silver-sat/Avionics_Board/Avionics_Board.step

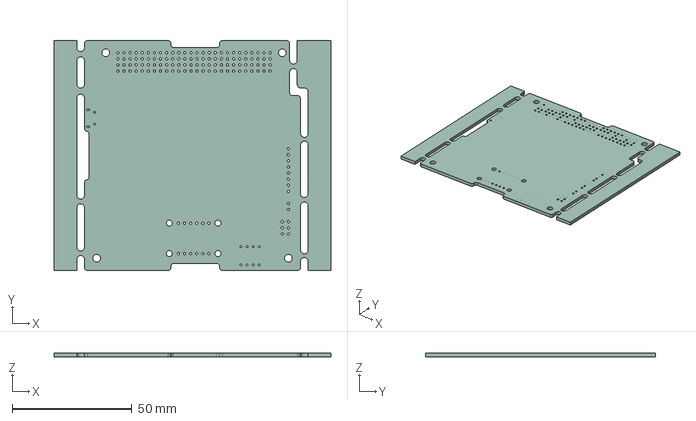
[picture p1: CAD file, 2024-04-20]
Avionics_Board.step
115.6 x 95.9 x 1.77 mm
