silver-sat/Avionics_Board/avionics_board_layout_04182022.dxf

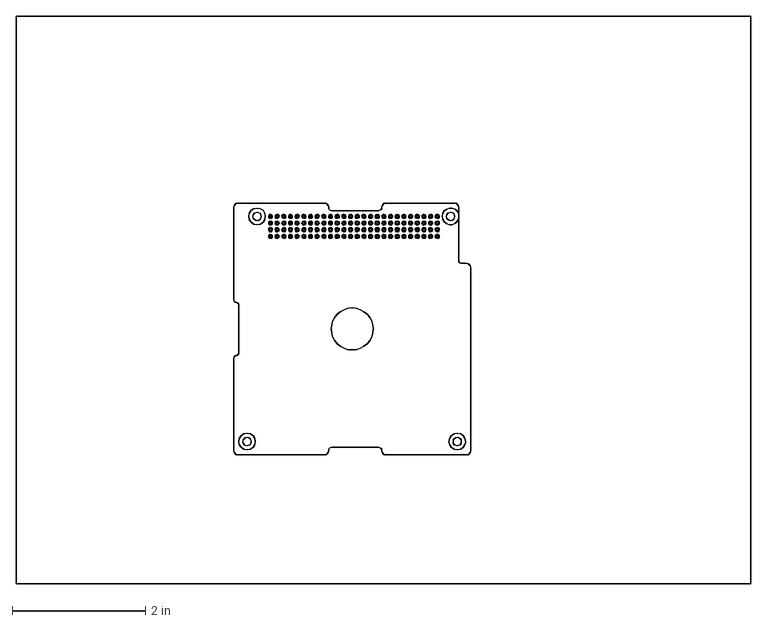
[picture p2: CAD file, 2023-02-25]
avionics_board_layout_04182022.dxf
11.0 x 8.50 in
