silver-sat/Avionics_Board/(threads)

Thread 4 (2023-06-26):

Payload Board Receives Power until Avionics Board Initializes

lcongdon, 2023-06-26:
See https://github.com/silver-sat/Avionics_Software/issues/332

lcongdon, 2023-06-28:
Also tracked as https://github.com/silver-sat/Payload_Board/issues/4

NiskiN, 2023-11-11:
The Pullup Resistors have been added.

Closed 2023-11-11.

Thread 5 (2023-06-28):

Jumpers for Power and Radio I2C Connections are Open

lcongdon, 2023-06-28:
Need to close clock and data jumpers for the Power and Radio I2C connections

NiskiN, 2023-11-11:
The Jumpers have been Closed

Closed 2023-11-11.
