silver-sat/Avionics_Board/Avionics_Board.kicad_pcb

## KiCad design Avionics_Board.kicad_pcb (2024-06-05)

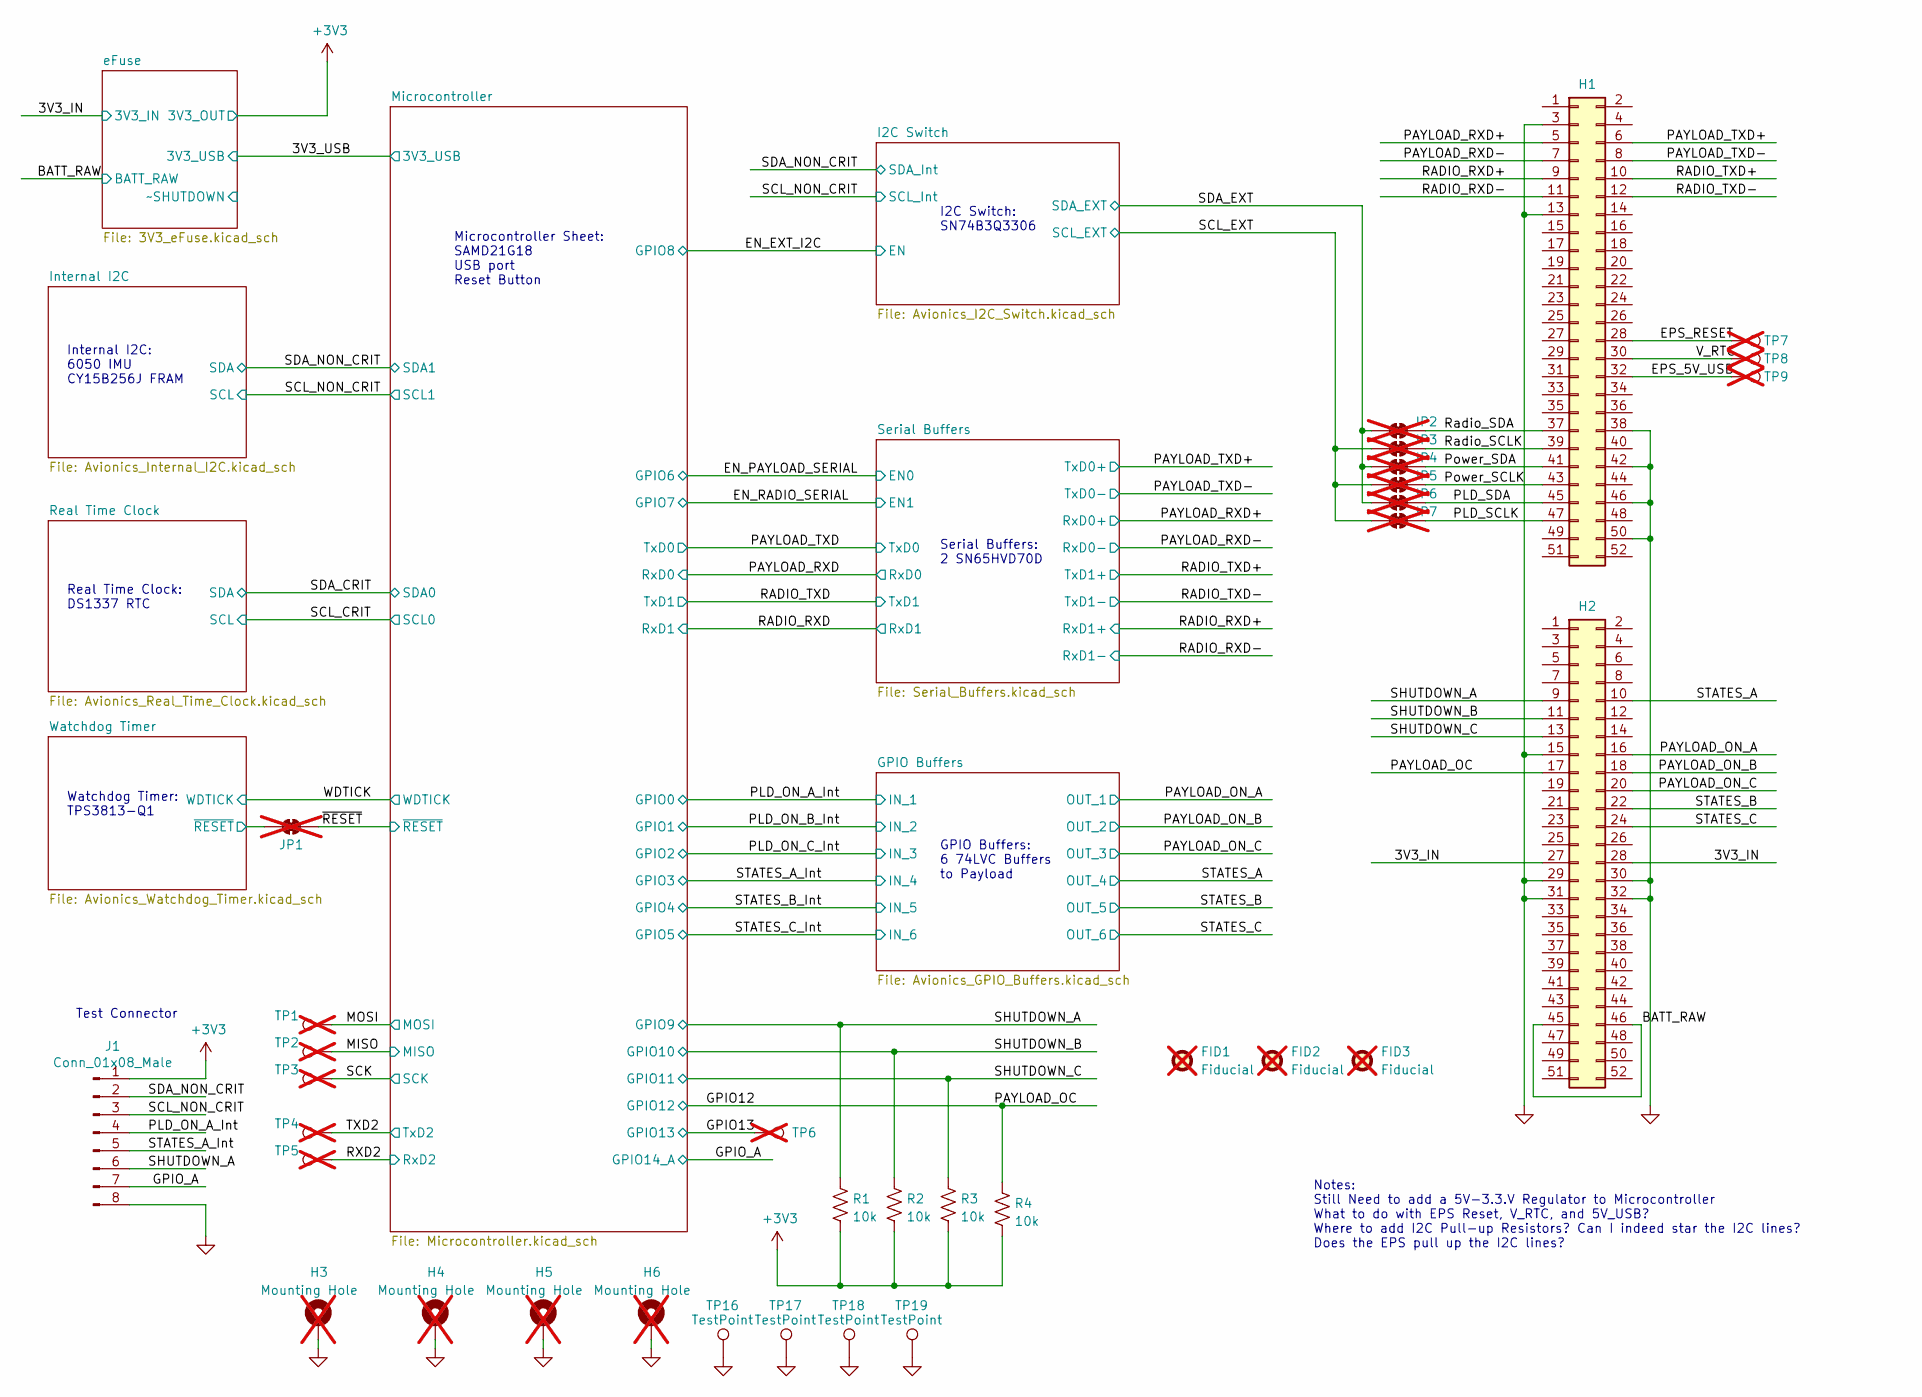
[picture p3: schematic Avionics_Board.kicad_sch, Avionics Board]

Parts:
FID1, FID2, FID3: Fiducial; Fiducial_1.5mm_Mask2.5mm; not fitted
H1, H2: Conn_02x26_Odd_Even; TheBus2x26; Part_Number ESQ-126-37-G-D
H3, H4, H5, H6: Mounting Hole; MountingHole_3.2mm_M3_Pad; not fitted
J1: Conn_01x08_Male; PinHeader_1x08_P2.54mm_Vertical; MPN TSW-108-26-L-S
JP1, JP2, JP3, JP4, JP5, JP6, JP7: SolderJumper_2_Bridged; SolderJumper-2_P1.3mm_Open_RoundedPad1.0x1.5mm; not fitted
R1, R2, R3, R4: 10k; R_0603_1608Metric; Part_Number ERJ-3EKF1002V
TP1: MOSI; TestPoint_Pad_2.0x2.0mm; not fitted
TP2: MISO; TestPoint_Pad_2.0x2.0mm; not fitted
TP3: SCK; TestPoint_Pad_2.0x2.0mm; not fitted
TP4: TXD2; TestPoint_Pad_2.0x2.0mm; not fitted
TP5: RXD2; TestPoint_Pad_2.0x2.0mm; not fitted
TP6: GPIO13; TestPoint_Pad_2.0x2.0mm; not fitted
TP7: EPS_RESET; TestPoint_Pad_2.0x2.0mm; not fitted
TP8: V_RTC; TestPoint_Pad_2.0x2.0mm; not fitted
TP9: EPS_5V_USB; TestPoint_Pad_2.0x2.0mm; not fitted
TP16, TP17, TP18, TP19: TestPoint; TestPoint_Keystone_5019_Minature; MPN 5019

Connections:
+3V3: J1.1, R1.2, R2.2, R3.2, R4.2; also elsewhere on the board
/3V3_IN: H2.27, H2.28; also elsewhere on the board
/BATT_RAW: H2.45, H2.46; also elsewhere on the board
/EPS_5V_USB: H1.32, TP9.1
/EPS_RESET: H1.28, TP7.1
/GPIO12: H2.17, R4.1; also elsewhere on the board
/GPIO13: TP6.1; also elsewhere on the board
/GPIO_A: J1.7; also elsewhere on the board
/MISO: TP2.1; also elsewhere on the board
/MOSI: TP1.1; also elsewhere on the board
/PAYLOAD_ON_A: H2.16; also elsewhere on the board
/PAYLOAD_ON_B: H2.18; also elsewhere on the board
/PAYLOAD_ON_C: H2.20; also elsewhere on the board
/PAYLOAD_RXD+: H1.5; also elsewhere on the board
/PAYLOAD_RXD-: H1.7; also elsewhere on the board
/PAYLOAD_TXD+: H1.6; also elsewhere on the board
/PAYLOAD_TXD-: H1.8; also elsewhere on the board
/PLD_ON_A_Int: J1.4; also elsewhere on the board
/PLD_SCLK: H1.47, JP7.2 (B)
/PLD_SDA: H1.45, JP6.2 (B)
/Power_SCLK: H1.43, JP5.2 (B)
/Power_SDA: H1.41, JP4.2 (B)
/RADIO_RXD+: H1.9; also elsewhere on the board
/RADIO_RXD-: H1.11; also elsewhere on the board
/RADIO_TXD+: H1.10; also elsewhere on the board
/RADIO_TXD-: H1.12; also elsewhere on the board
/RXD2: TP5.1; also elsewhere on the board
/Radio_SCLK: H1.39, JP3.2 (B)
/Radio_SDA: H1.37, JP2.2 (B)
/SCK: TP3.1; also elsewhere on the board
/SCL_EXT: JP3.1 (A), JP5.1 (A), JP7.1 (A); also elsewhere on the board
/SCL_NON_CRIT: J1.3; also elsewhere on the board
/SDA_EXT: JP2.1 (A), JP4.1 (A), JP6.1 (A); also elsewhere on the board
/SDA_NON_CRIT: J1.2; also elsewhere on the board
/SHUTDOWN_A: H2.9, J1.6, R1.1; also elsewhere on the board
/SHUTDOWN_B: H2.11, R2.1; also elsewhere on the board
/SHUTDOWN_C: H2.13, R3.1; also elsewhere on the board
/STATES_A: H2.10; also elsewhere on the board
/STATES_A_Int: J1.5; also elsewhere on the board
/STATES_B: H2.22; also elsewhere on the board
/STATES_C: H2.24; also elsewhere on the board
/TXD2: TP4.1; also elsewhere on the board
/V_RTC: H1.30, TP8.1
/Watchdog Timer/~RESET: JP1.1 (A); also elsewhere on the board
/~RESET: JP1.2 (B); also elsewhere on the board
GND: H1.3, H1.13, H1.38, H1.42, H1.46, H1.50, H2.15, H2.29, H2.30, H2.31, H2.32, H3.1, H4.1, H5.1, H6.1, J1.8, TP16.1, TP17.1, TP18.1, TP19.1; also elsewhere on the board

Notes on the sheet:
GPIO Buffers: 6 74LVC Buffers to Payload
Serial Buffers: 2 SN65HVD70D
Watchdog Timer: TPS3813-Q1
Real Time Clock: DS1337 RTC
Microcontroller Sheet: SAMD21G18 USB port Reset Button
Notes: Still Need to add a 5V-3.3.V Regulator to Microcontroller What to do with EPS Reset, V_RTC, and 5V_USB? Where to add I2C Pull-up Resistors? Can I indeed star the I2C lines? Does the EPS pull up the I2C lines?
Internal I2C: 6050 IMU CY15B256J FRAM
I2C Switch: SN74B3Q3306
Test Connector

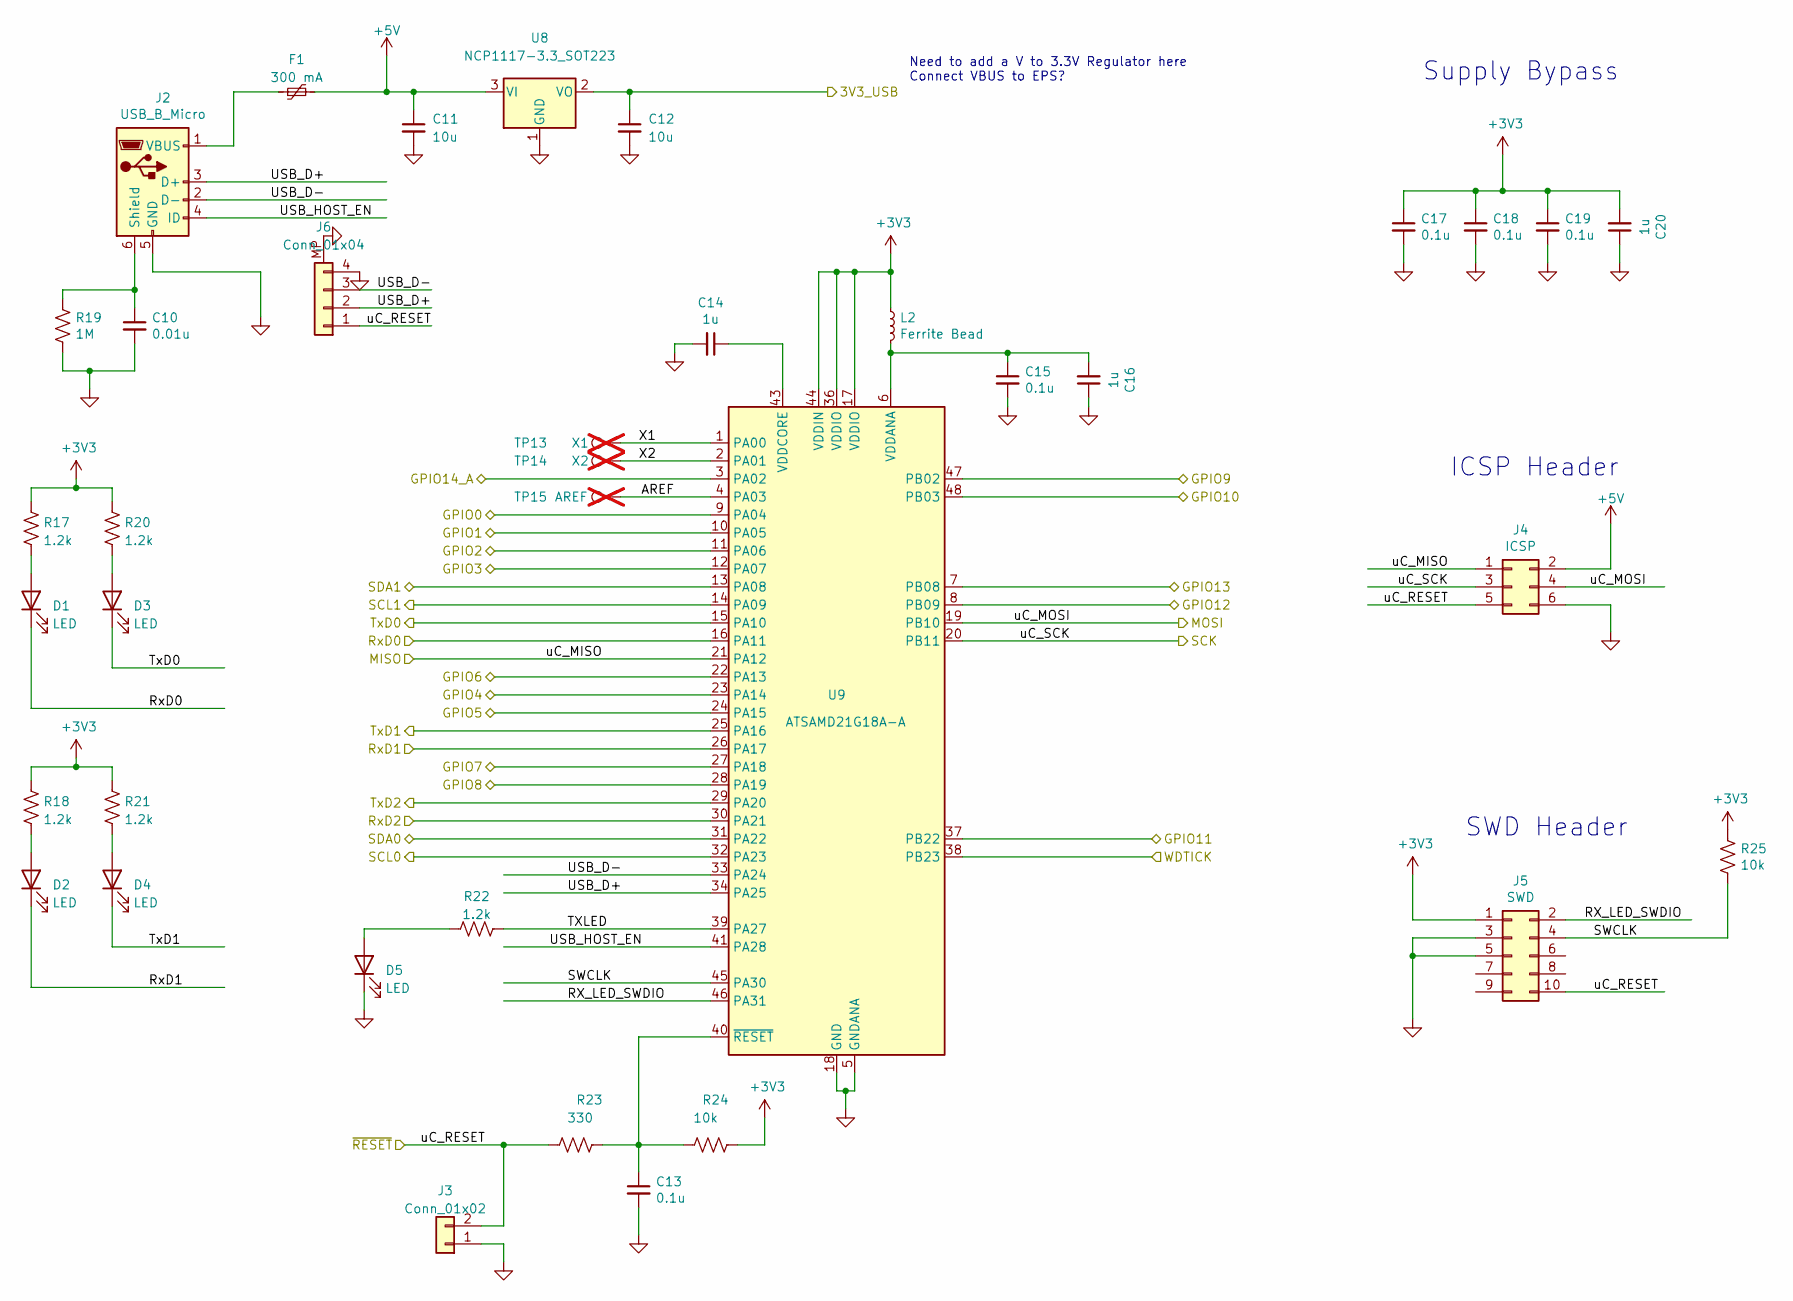
[picture p4: schematic Microcontroller.kicad_sch, Avionics Board]

Parts:
C10: 0.01u; C_0603_1608Metric; Part_Number 06035C472K4Z2A
C11, C12: 10u; C_2220_5650Metric_Pad1.97x5.40mm_HandSolder; Part_Number 22205C106K4Z4A
C13, C15, C17, C18, C19: 0.1u; C_0603_1608Metric; Part_Number 06035C104K4Z2A
C14, C16, C20: 1u; C_1206_3216Metric; Part_Number 12065C105M4Z2A
D1, D2, D3, D4, D5: LED; LED_0603_1608Metric; MPN CSL0903UT1C
F1: 300 mA; Fuse_0805_2012Metric; Part_Number PICOASMDC012S-2
J2: USB_B_Micro; USB_Micro-B_Molex-105017-0001; Part_Number 105017-0001
J3: Conn_01x02; PinHeader_1x02_P2.54mm_Vertical; MPN TSW-102-26-L-S
J4: ICSP; PinHeader_2x03_P2.54mm_Vertical; MPN MTSW-103-06-G-D-110
J5: SWD; PinHeader_2x05_P1.27mm_Vertical_SMD; Part_Number 4048
J6: Conn_01x04; Molex_PicoBlade_53261-0471_1x04-1MP_P1.25mm_Horizontal; MPN 53261-0471
L2: Ferrite Bead; L_0603_1608Metric; Part_Number BLM18SP102SH1D
R17, R18, R20, R21, R22: 1.2k; R_0603_1608Metric; Part_Number ERJ-3EKF9310V
R19: 1M; R_0603_1608Metric; Part_Number ERJ-3EKF1004V
R23: 330; R_0603_1608Metric; Part_Number ERJ-3EKF3300V
R24, R25: 10k; R_0603_1608Metric; Part_Number ERJ-3EKF1002V
TP13: X1; TestPoint_Pad_2.0x2.0mm; not fitted
TP14: X2; TestPoint_Pad_2.0x2.0mm; not fitted
TP15: AREF; TestPoint_Pad_2.0x2.0mm; not fitted
U8: NCP1117-3.3_SOT223; SOT-223-3_TabPin2; Part_Number NCP1117
U9: ATSAMD21G18A-A; TQFP-48_7x7mm_P0.5mm; Part_Number ATSAMD21G18A-AF

Connections:
+3V3: C17.1, C18.1, C19.1, C20.2, J5.1, L2.1, R17.1, R18.1, R20.1, R21.1, R24.1, R25.1, U9.17 (VDDIO), U9.36 (VDDIO), U9.44 (VDDIN); also elsewhere on the board
+5V: C11.1, F1.2, J4.2, U8.3 (VI)
/3V3_USB: C12.1, U8.2 (VO); also elsewhere on the board
/EN_EXT_I2C: U9.28 (PA19); also elsewhere on the board
/EN_PAYLOAD_SERIAL: U9.22 (PA13); also elsewhere on the board
/EN_RADIO_SERIAL: U9.27 (PA18); also elsewhere on the board
/GPIO12: U9.8 (PB09); also elsewhere on the board
/GPIO13: U9.7 (PB08); also elsewhere on the board
/GPIO_A: U9.3 (PA02); also elsewhere on the board
/MISO: J4.1, U9.21 (PA12); also elsewhere on the board
/MOSI: J4.4, U9.19 (PB10); also elsewhere on the board
/Microcontroller/AREF: TP15.1, U9.4 (PA03)
/Microcontroller/RX_LED_SWDIO: J5.2, U9.46 (PA31)
/Microcontroller/SWCLK: J5.4, R25.2, U9.45 (PA30)
/Microcontroller/TXLED: R22.2, U9.39 (PA27)
/Microcontroller/USB_D+: J2.3 (D+), J6.2, U9.34 (PA25)
/Microcontroller/USB_D-: J2.2 (D-), J6.3, U9.33 (PA24)
/Microcontroller/USB_HOST_EN: J2.4 (ID), U9.41 (PA28)
/Microcontroller/X1: TP13.1, U9.1 (PA00)
/Microcontroller/X2: TP14.1, U9.2 (PA01)
/PAYLOAD_RXD: D1.1 (K), U9.16 (PA11); also elsewhere on the board
/PAYLOAD_TXD: D3.1 (K), U9.15 (PA10); also elsewhere on the board
/PLD_ON_A_Int: U9.9 (PA04); also elsewhere on the board
/PLD_ON_B_Int: U9.10 (PA05); also elsewhere on the board
/PLD_ON_C_Int: U9.11 (PA06); also elsewhere on the board
/RADIO_RXD: D2.1 (K), U9.26 (PA17); also elsewhere on the board
/RADIO_TXD: D4.1 (K), U9.25 (PA16); also elsewhere on the board
/RXD2: U9.30 (PA21); also elsewhere on the board
/SCK: J4.3, U9.20 (PB11); also elsewhere on the board
/SCL_CRIT: U9.32 (PA23); also elsewhere on the board
/SCL_NON_CRIT: U9.14 (PA09); also elsewhere on the board
/SDA_CRIT: U9.31 (PA22); also elsewhere on the board
/SDA_NON_CRIT: U9.13 (PA08); also elsewhere on the board
/SHUTDOWN_A: U9.47 (PB02); also elsewhere on the board
/SHUTDOWN_B: U9.48 (PB03); also elsewhere on the board
/SHUTDOWN_C: U9.37 (PB22); also elsewhere on the board
/STATES_A_Int: U9.12 (PA07); also elsewhere on the board
/STATES_B_Int: U9.23 (PA14); also elsewhere on the board
/STATES_C_Int: U9.24 (PA15); also elsewhere on the board
/TXD2: U9.29 (PA20); also elsewhere on the board
/WDTICK: U9.38 (PB23); also elsewhere on the board
/~RESET: J3.2, J4.5, J5.10, J6.1, R23.2; also elsewhere on the board
GND: C10.2, C11.2, C12.2, C13.2, C14.2, C15.2, C16.1, C17.2, C18.2, C19.2, C20.1, D5.1 (K), J2.5 (GND), J3.1, J4.6, J5.3, J5.5, J6.4, J6.MP, R19.2, U8.1 (GND), U9.5 (GNDANA), U9.18 (GND), U9.35 (GND), U9.42 (GND); also elsewhere on the board
unnamed: D1.2 (A), R17.2
unnamed: D2.2 (A), R18.2
unnamed: D3.2 (A), R20.2
unnamed: D4.2 (A), R21.2
unnamed: D5.2 (A), R22.1
unnamed: C10.1, J2.6 (Shield), R19.1
unnamed: F1.1, J2.1 (VBUS)
unnamed: C15.1, C16.2, L2.2, U9.6 (VDDANA)
unnamed: C14.1, U9.43 (VDDCORE)
unnamed: C13.1, R23.1, R24.2, U9.40 (~RESET)

Notes on the sheet:
Need to add a V to 3.3V Regulator here Connect VBUS to EPS?
ICSP Header
SWD Header
Supply Bypass

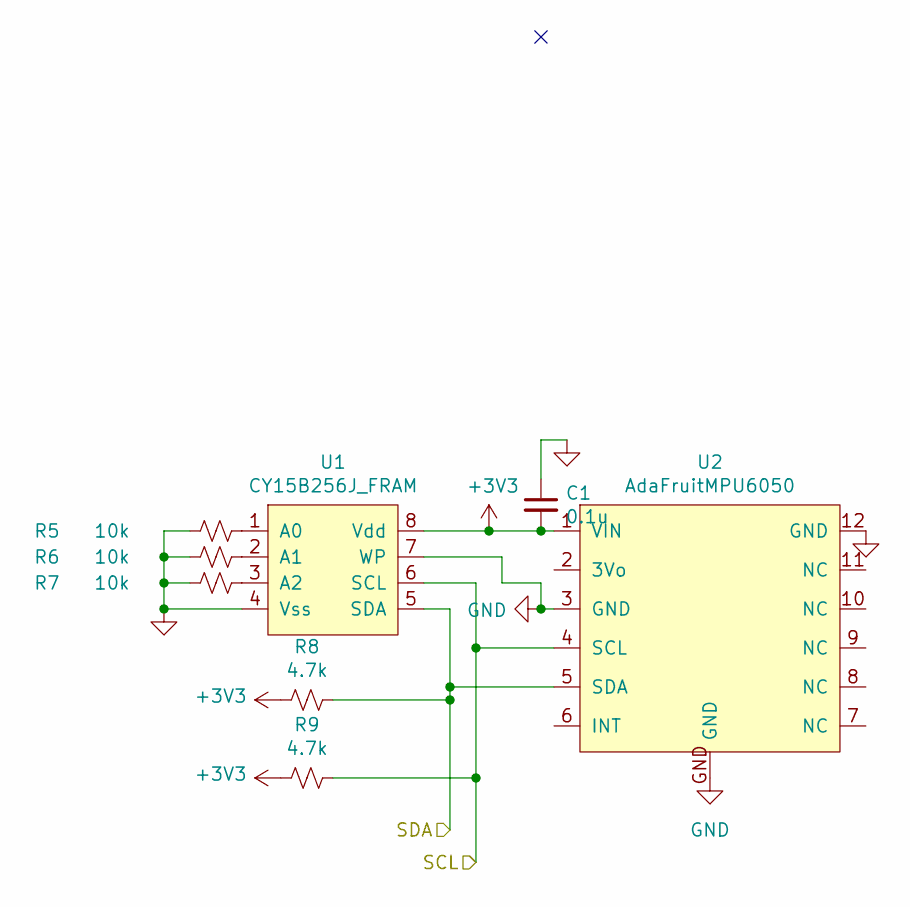
[picture p5: schematic Avionics_Internal_I2C.kicad_sch, Avionics Board]

Parts:
C1: 0.1u; C_0603_1608Metric; Part_Number 06035C104K4Z2A
R5, R6, R7: 10k; R_0603_1608Metric; Part_Number ERJ-3EKF1002V
R8, R9: 4.7k; R_0603_1608Metric; Part_Number ERJ-3EKF4701V
U1: CY15B256J_FRAM; SOP-8_5.28x5.23mm_P1.27mm; Part_Number CY15B256J
U2: AdaFruitMPU6050; MPU_6050; Part_Number MPU6050

Connections:
+3V3: C1.2, R8.2, R9.2, U1.8 (Vdd), U2.1 (VIN); also elsewhere on the board
/SCL_NON_CRIT: R9.1, U1.6 (SCL), U2.4 (SCL); also elsewhere on the board
/SDA_NON_CRIT: R8.1, U1.5 (SDA), U2.5 (SDA); also elsewhere on the board
GND: C1.1, R5.2, R6.2, R7.2, U1.4 (Vss), U1.7 (WP), U2.3 (GND), U2.12 (GND), U2.GND; also elsewhere on the board
unnamed: R5.1, U1.1 (A0)
unnamed: R6.1, U1.2 (A1)
unnamed: R7.1, U1.3 (A2)

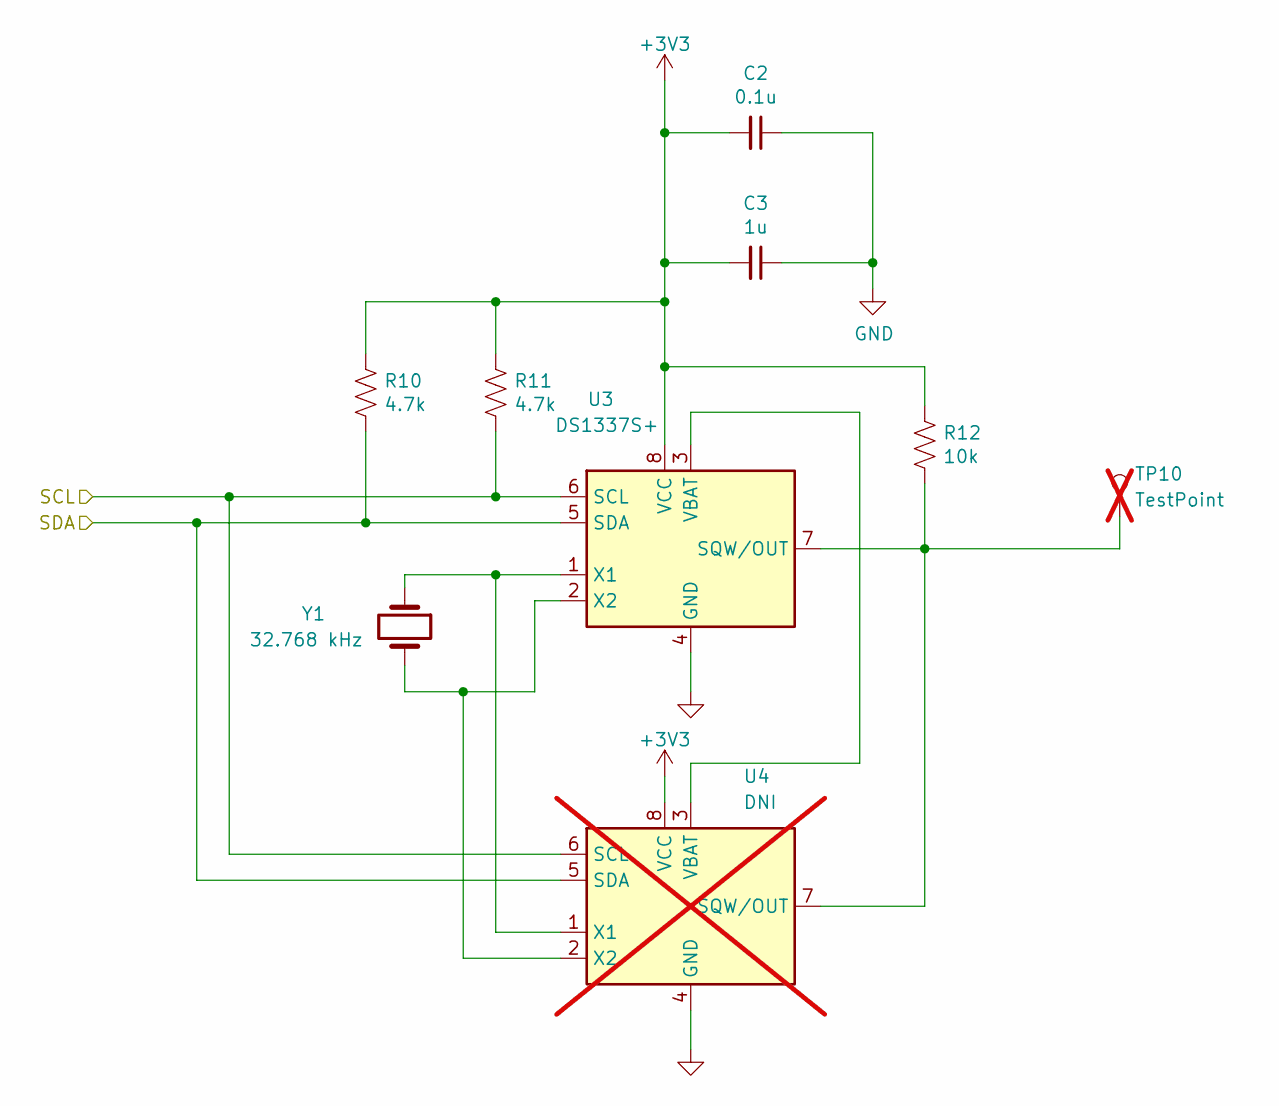
[picture p6: schematic Avionics_Real_Time_Clock.kicad_sch, Avionics Board]

Parts:
C2: 0.1u; C_0603_1608Metric; Part_Number 06035C104K4Z2A
C3: 1u; C_1206_3216Metric; Part_Number 12065C105M4Z2A
R10, R11: 4.7k; R_0603_1608Metric; Part_Number ERJ-3EKF4701V
R12: 10k; R_0603_1608Metric; Part_Number ERJ-3EKF1002V
TP10: TestPoint; TestPoint_Pad_2.0x2.0mm; not fitted
U3: DS1337S+; SOIC-8_3.9x4.9mm_P1.27mm; Part_Number DS1337S+T&R
U4: DNI; DIP-8_W7.62mm; Part_Number DS1337+; not fitted
Y1: 32.768 kHz; Crystal_SMD_3215-2Pin_3.2x1.5mm; Part_Number ECS-.327-6-34QCS-TR

Connections:
+3V3: C2.2, C3.2, R10.1, R11.1, R12.1, U3.8 (VCC), U4.8 (VCC); also elsewhere on the board
/SCL_CRIT: R11.2, U3.6 (SCL), U4.6 (SCL); also elsewhere on the board
/SDA_CRIT: R10.2, U3.5 (SDA), U4.5 (SDA); also elsewhere on the board
GND: C2.1, C3.1, U3.4 (GND), U4.4 (GND); also elsewhere on the board
unnamed: R12.2, TP10.1, U3.7 (SQW/OUT), U4.7 (SQW/OUT)
unnamed: U3.3 (VBAT), U4.3 (VBAT)
unnamed: U3.1 (X1), U4.1 (X1), Y1.1
unnamed: U3.2 (X2), U4.2 (X2), Y1.2

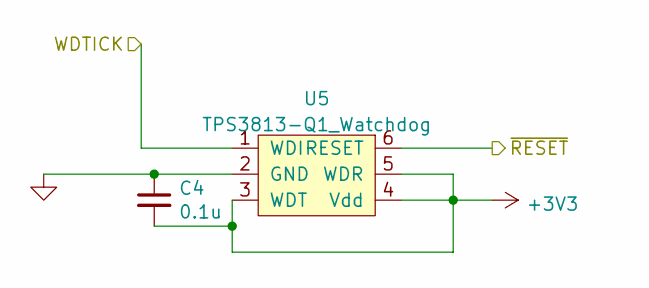
[picture p7: schematic Avionics_Watchdog_Timer.kicad_sch, Avionics Board]

Parts:
C4: 0.1u; C_0603_1608Metric; Part_Number 06035C104K4Z2A
U5: TPS3813-Q1_Watchdog; SOT-23-6; Part_Number TPS3813I50QDBVRQ1

Connections:
+3V3: C4.2, U5.3 (WDT), U5.4 (Vdd), U5.5 (WDR); also elsewhere on the board
/WDTICK: U5.1 (WDI); also elsewhere on the board
/Watchdog Timer/~RESET: U5.6 (RESET); also elsewhere on the board
GND: C4.1, U5.2 (GND); also elsewhere on the board

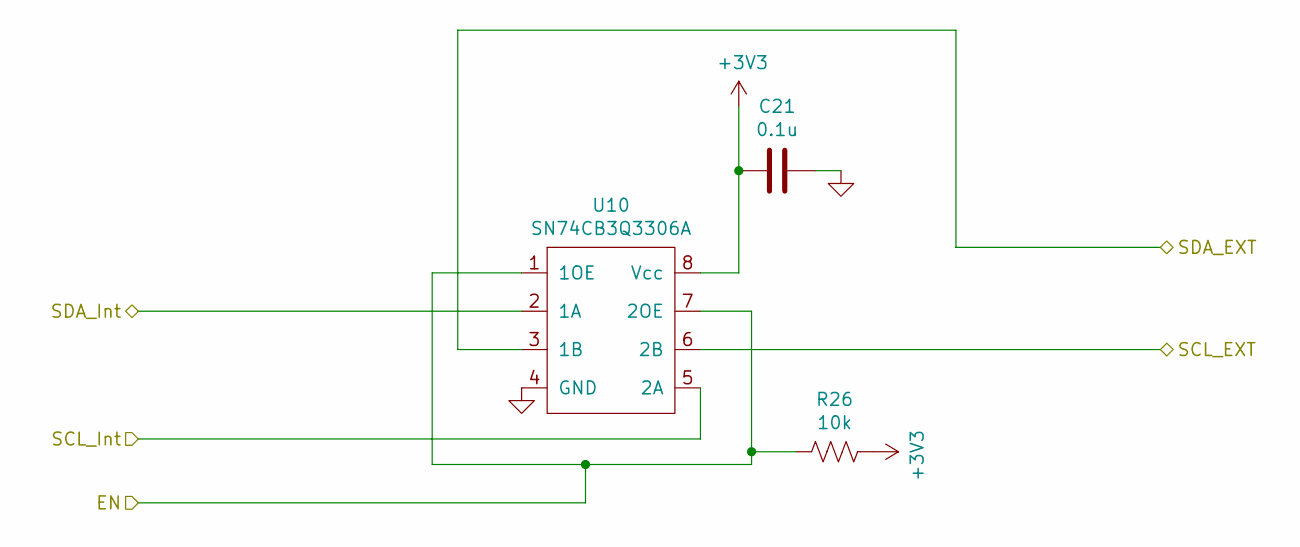
[picture p8: schematic Avionics_I2C_Switch.kicad_sch, Avionics Board]

Parts:
C21: 0.1u; C_0603_1608Metric; Part_Number 06035C104K4Z2A
R26: 10k; R_0603_1608Metric; Part_Number ERJ-3EKF1002V
U10: SN74CB3Q3306A; TSSOP-8_4.4x3mm_P0.65mm; Part_Number SN74CB3Q3306A

Connections:
+3V3: C21.1, R26.1, U10.8 (Vcc); also elsewhere on the board
/EN_EXT_I2C: R26.2, U10.1 (1OE), U10.7 (2OE); also elsewhere on the board
/SCL_EXT: U10.6 (2B); also elsewhere on the board
/SCL_NON_CRIT: U10.5 (2A); also elsewhere on the board
/SDA_EXT: U10.3 (1B); also elsewhere on the board
/SDA_NON_CRIT: U10.2 (1A); also elsewhere on the board
GND: C21.2, U10.4 (GND); also elsewhere on the board

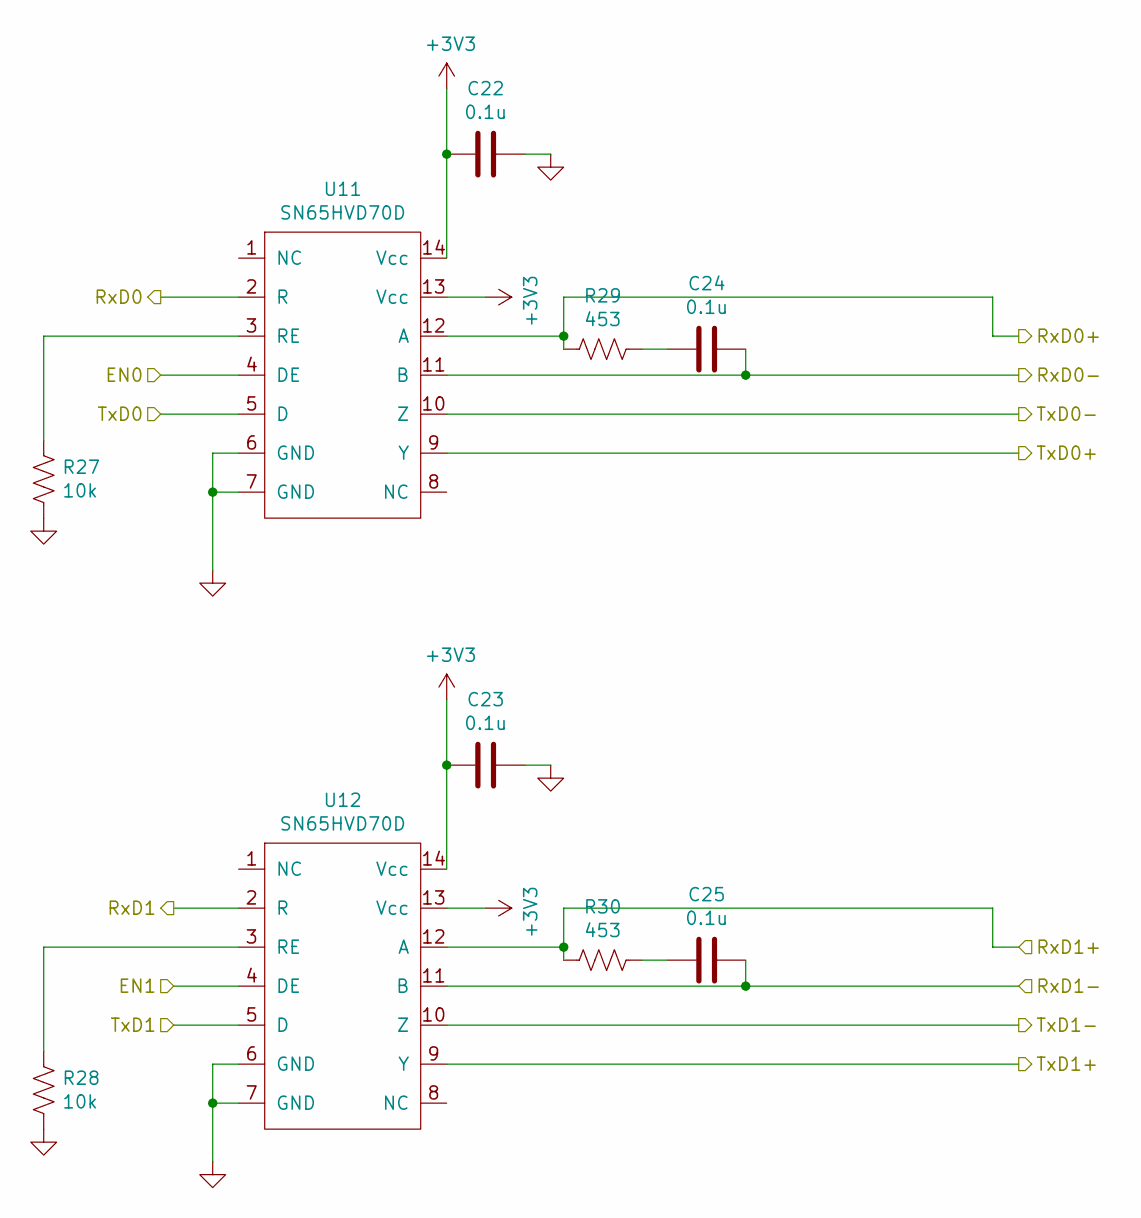
[picture p9: schematic Serial_Buffers.kicad_sch, Avionics Board]

Parts:
C22, C23, C24, C25: 0.1u; C_0603_1608Metric; Part_Number 06035C104K4Z2A
R27, R28: 10k; R_0603_1608Metric; Part_Number ERJ-3EKF1002V
R29, R30: 453; R_0603_1608Metric; Part_Number ERJ-3EKF4530V
U11, U12: SN65HVD70D; SOIC-14_3.9x8.7mm_P1.27mm; Part_Number SN65HVD70D

Connections:
+3V3: C22.1, C23.1, U11.13 (Vcc), U11.14 (Vcc), U12.13 (Vcc), U12.14 (Vcc); also elsewhere on the board
/EN_PAYLOAD_SERIAL: U11.4 (DE); also elsewhere on the board
/EN_RADIO_SERIAL: U12.4 (DE); also elsewhere on the board
/PAYLOAD_RXD: U11.2 (R); also elsewhere on the board
/PAYLOAD_RXD+: R29.2, U11.12 (A); also elsewhere on the board
/PAYLOAD_RXD-: C24.2, U11.11 (B); also elsewhere on the board
/PAYLOAD_TXD: U11.5 (D); also elsewhere on the board
/PAYLOAD_TXD+: U11.9 (Y); also elsewhere on the board
/PAYLOAD_TXD-: U11.10 (Z); also elsewhere on the board
/RADIO_RXD: U12.2 (R); also elsewhere on the board
/RADIO_RXD+: R30.2, U12.12 (A); also elsewhere on the board
/RADIO_RXD-: C25.2, U12.11 (B); also elsewhere on the board
/RADIO_TXD: U12.5 (D); also elsewhere on the board
/RADIO_TXD+: U12.9 (Y); also elsewhere on the board
/RADIO_TXD-: U12.10 (Z); also elsewhere on the board
GND: C22.2, C23.2, R27.2, R28.2, U11.6 (GND), U11.7 (GND), U12.6 (GND), U12.7 (GND); also elsewhere on the board
unnamed: C24.1, R29.1
unnamed: C25.1, R30.1
unnamed: R27.1, U11.3 (RE)
unnamed: R28.1, U12.3 (RE)

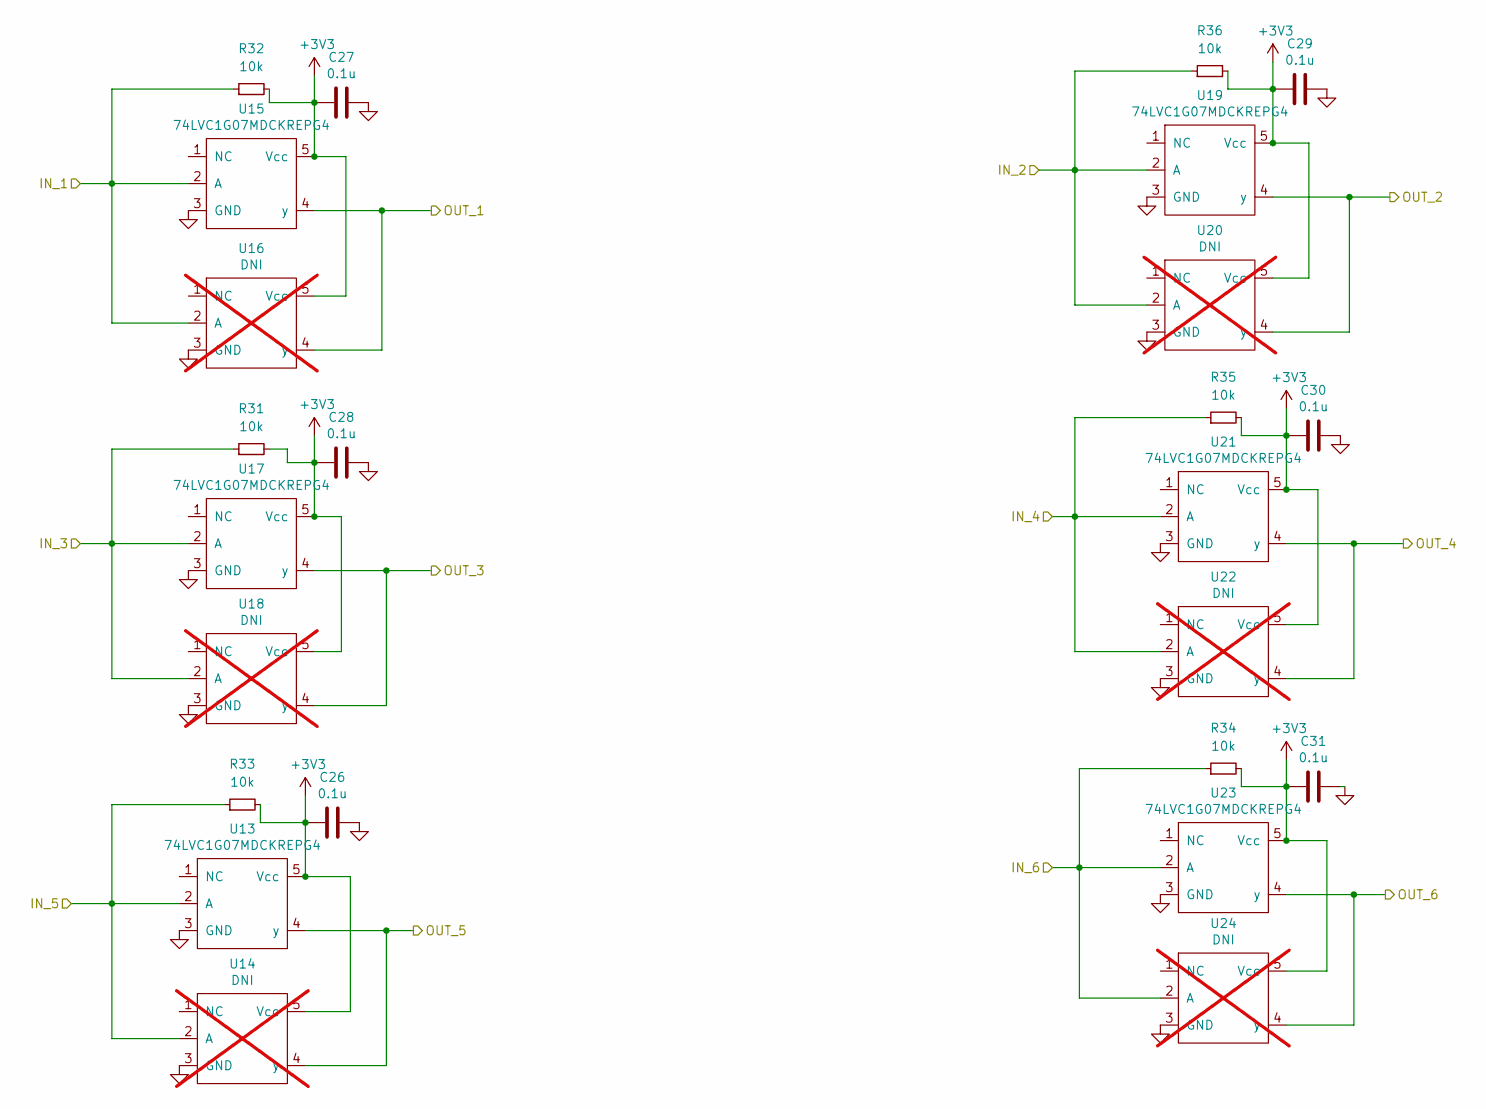
[picture p10: schematic Avionics_GPIO_Buffers.kicad_sch, Avionics Board]

Parts:
C26, C27, C28, C29, C30, C31: 0.1u; C_0603_1608Metric; Part_Number 06035C104K4Z2A
R31, R32, R33, R34, R35, R36: 10k; R_0603_1608Metric; MPN ERJ-3RBD1002V
U13, U15, U17, U19, U21, U23: 74LVC1G07MDCKREPG4; SOT-353_SC-70-5; Part_Number 74LVC1G07MDCKREPG4
U14, U16, U18, U20, U22, U24: DNI; SOT-23-5; not fitted

Connections:
+3V3: C26.2, C27.2, C28.2, C29.2, C30.2, C31.2, R31.2, R32.2, R33.2, R34.2, R35.2, R36.2, U13.5 (Vcc), U14.5 (Vcc), U15.5 (Vcc), U16.5 (Vcc), U17.5 (Vcc), U18.5 (Vcc), U19.5 (Vcc), U20.5 (Vcc), U21.5 (Vcc), U22.5 (Vcc), U23.5 (Vcc), U24.5 (Vcc); also elsewhere on the board
/PAYLOAD_ON_A: U15.4 (y), U16.4 (y); also elsewhere on the board
/PAYLOAD_ON_B: U19.4 (y), U20.4 (y); also elsewhere on the board
/PAYLOAD_ON_C: U17.4 (y), U18.4 (y); also elsewhere on the board
/PLD_ON_A_Int: R32.1, U15.2 (A), U16.2 (A); also elsewhere on the board
/PLD_ON_B_Int: R36.1, U19.2 (A), U20.2 (A); also elsewhere on the board
/PLD_ON_C_Int: R31.1, U17.2 (A), U18.2 (A); also elsewhere on the board
/STATES_A: U21.4 (y), U22.4 (y); also elsewhere on the board
/STATES_A_Int: R35.1, U21.2 (A), U22.2 (A); also elsewhere on the board
/STATES_B: U13.4 (y), U14.4 (y); also elsewhere on the board
/STATES_B_Int: R33.1, U13.2 (A), U14.2 (A); also elsewhere on the board
/STATES_C: U23.4 (y), U24.4 (y); also elsewhere on the board
/STATES_C_Int: R34.1, U23.2 (A), U24.2 (A); also elsewhere on the board
GND: C26.1, C27.1, C28.1, C29.1, C30.1, C31.1, U13.3 (GND), U14.3 (GND), U15.3 (GND), U16.3 (GND), U17.3 (GND), U18.3 (GND), U19.3 (GND), U20.3 (GND), U21.3 (GND), U22.3 (GND), U23.3 (GND), U24.3 (GND); also elsewhere on the board

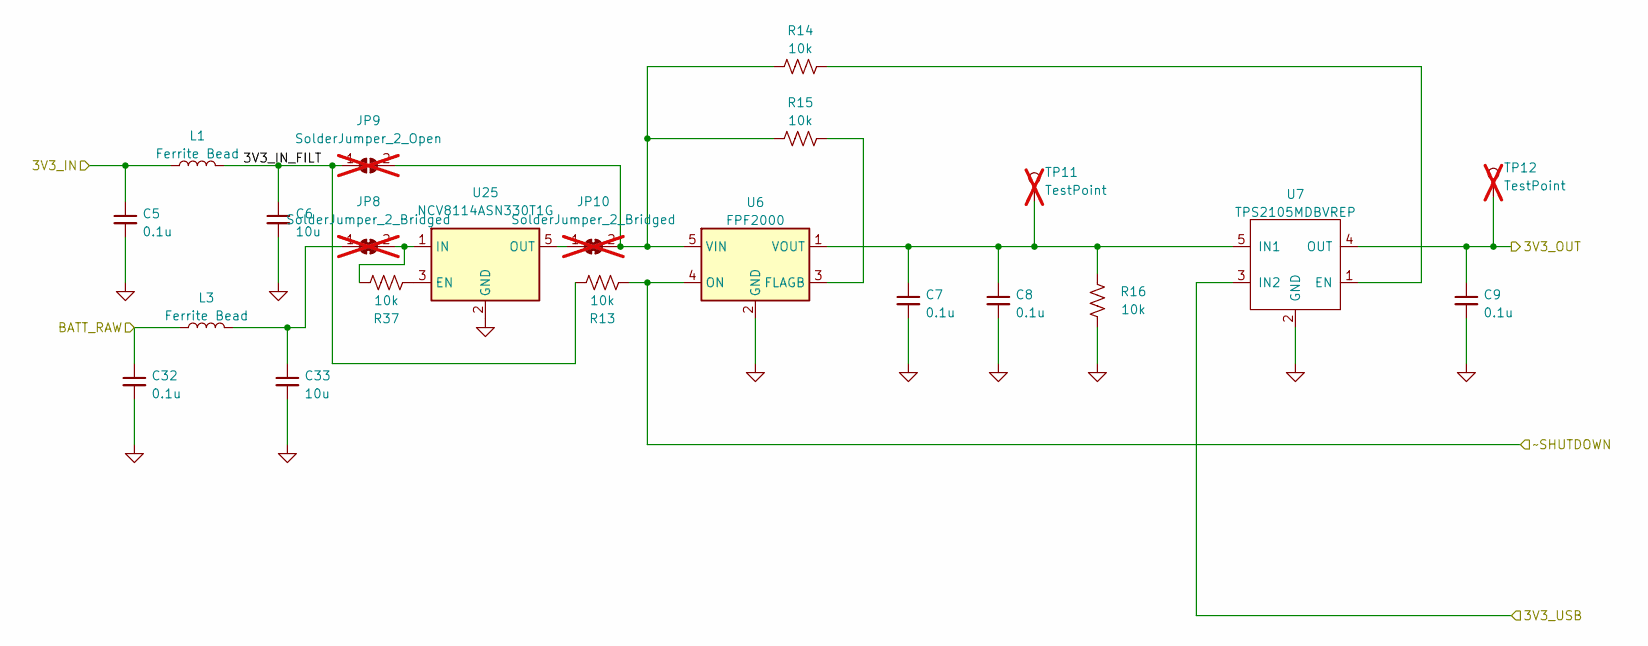
[picture p11: schematic 3V3_eFuse.kicad_sch, Avionics Board]

Parts:
C5, C7, C8, C9, C32: 0.1u; C_0603_1608Metric; Part_Number 06035C104K4Z2A
C6: 10u; C_2220_5650Metric_Pad1.97x5.40mm_HandSolder; Part_Number 22205C106K4Z4A
C33: 10u; C_0603_1608Metric; Part_Number 22205C106K4Z4A
JP8, JP10: SolderJumper_2_Bridged; SolderJumper-2_P1.3mm_Bridged_RoundedPad1.0x1.5mm; not fitted
JP9: SolderJumper_2_Open; SolderJumper-2_P1.3mm_Open_TrianglePad1.0x1.5mm; not fitted
L1, L3: Ferrite Bead; L_0603_1608Metric; Part_Number BLM18SP102SH1D
R13, R14, R15, R16, R37: 10k; R_0603_1608Metric; Part_Number ERJ-3EKF1002V
TP11, TP12: TestPoint; TestPoint_Pad_2.0x2.0mm; not fitted
U6: FPF2000; SOT-353_SC-70-5; Part_Number FPF2000
U7: TPS2105MDBVREP; SOT-23-5; Part_Number TPS2105MDBVREP
U25: NCV8114ASN330T1G; TSOT-23-5; MPN NCV8114ASN330T1G

Connections:
+3V3: C9.1, TP12.1, U7.4 (OUT); also elsewhere on the board
/3V3_IN: C5.1, L1.1; also elsewhere on the board
/3V3_USB: U7.3 (IN2); also elsewhere on the board
/BATT_RAW: C32.1, L3.1; also elsewhere on the board
/eFuse/3V3_IN_FILT: C6.1, JP9.1 (A), L1.2, R13.1
/eFuse/~SHUTDOWN: R13.2, U6.4 (ON)
GND: C5.2, C6.2, C7.2, C8.2, C9.2, C32.2, C33.2, R16.2, U6.2 (GND), U7.2 (GND), U25.2 (GND); also elsewhere on the board
unnamed: C33.1, JP8.1 (A), L3.2
unnamed: JP8.2 (B), R37.1, U25.1 (IN)
unnamed: JP10.1 (A), U25.5 (OUT)
unnamed: JP9.2 (B), JP10.2 (B), R14.1, R15.1, U6.5 (VIN)
unnamed: R15.2, U6.3 (FLAGB)
unnamed: C7.1, C8.1, R16.1, TP11.1, U6.1 (VOUT), U7.5 (IN1)
unnamed: R14.2, U7.1 (EN)
unnamed: R37.2, U25.3 (EN)
