silver-sat/Avionics_Board/Avionics_Board.kicad_pcb

## KiCad design Avionics_Board.kicad_pcb (continued)

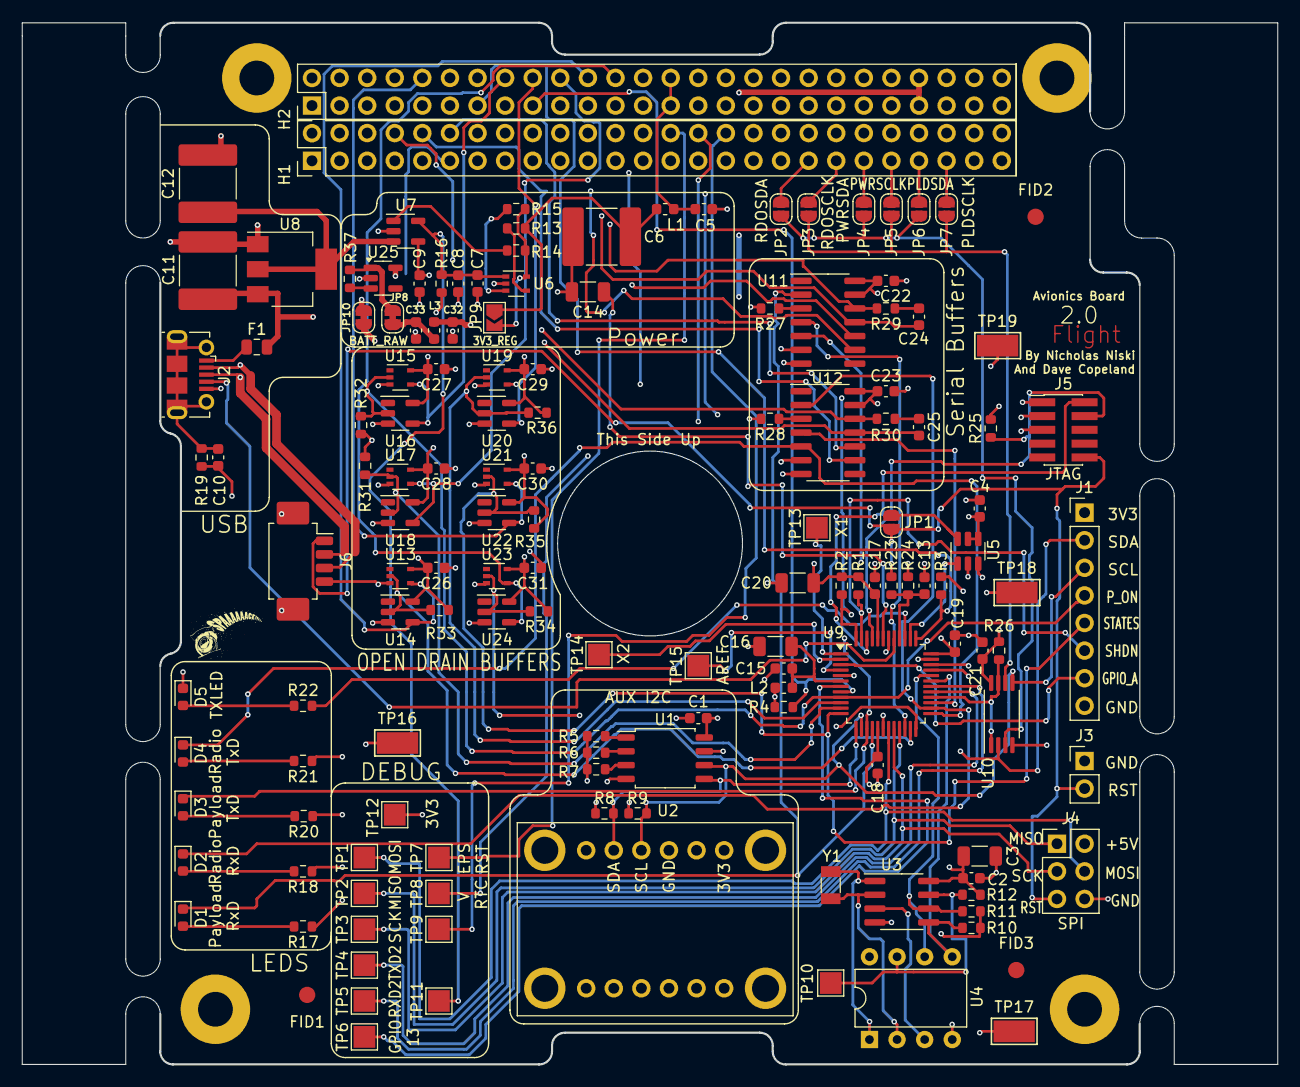
[picture p12: board Avionics_Board.kicad_pcb from above]

Board: 4 copper layers, 115.6 x 95.9 mm, 149 parts (0 on the bottom side), 102 nets.
