silver-sat/Avionics_Board/(commit log)

2023-02-25 Avionics Board V1.0 ReReleased!
    Mostly a movement, nothing else.
    Patch Notes:
    1. Migrated Avionics Board from /board-designs to a dedicated /Avionics_Board
    Note: Board works with all(not the external watchdog) components without white-wiring! (Good Job whoever person made the schematic.)
    [3V3_eFuse.kicad_sch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]
2023-10-14 Avionics Board V1.1 Released!
    The Start of Something New.
    1. Changed Debug LEDs from Discrete
    to SMD(0603)
    2. Beginning Silkscreen Update(Adding More Info on Silkscreen About Headers and Sectors)
    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
    [Avionics_Board.kicad_pcb]
2024-01-20 Avionics Board V1.2
    On our way to CDR
    1. Finally fixed some problems with the Open-Drain Buffers, Fixing a miswire on some DNI components and adding pullup resistors on the buffers to prevent incorrect signalling on board boot.
    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
    [3V3_eFuse.kicad_sch, Avionics_Board.kicad_pcb, Avionics_Board.kicad_sch, Avionics_GPIO_Buffers.kicad_sch, Avionics_I2C_Switch.kicad_sch, Avionics_Internal_I2C.kicad_sch, Avionics_Real_Time_Clock.kicad_sch, Avionics_Watchdog_Timer.kicad_sch]
2024-03-02 Avionics Board V 1.3 Released!
    Its almost done-ish!
    1. Silkscreen Updated Even More
    2. Minor Hardware Issues Fixed
    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
    [Avionics_Board.kicad_pcb]
2024-03-13 Updating to KiCad 8.0
    1. To be honest this should be the same as the V1.3 but Github is saying a ton of stuff changed so new upload i guess?
    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
    [3V3_eFuse.kicad_sch, Avionics_Board.kicad_pcb, Avionics_Board.kicad_sch, Avionics_GPIO_Buffers.kicad_sch, Avionics_I2C_Switch.kicad_sch, Avionics_Internal_I2C.kicad_sch, Avionics_Real_Time_Clock.kicad_sch, Avionics_Watchdog_Timer.kicad_sch]
2024-03-13 V1.35 Released!
    1. Fixed some errors with the DNP Open-Drain buffers and the NC Pads
    2. Fixed Pin Assignments for the H2 Headers, Finally.
    3. Updated the mounting hole footprint from the library as its pads wasnt assigned for some reason.
    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
    [Avionics_Board.kicad_pcb, Avionics_Board.kicad_sch]
2024-03-16 We Fixed Some things.
    For some reason KiCad 8 eeschema decided to nuke all the footprints. This has been fixed.
    [3V3_eFuse.kicad_sch, Avionics_Board.kicad_pcb, Avionics_Board.kicad_sch, Avionics_GPIO_Buffers.kicad_sch, Avionics_I2C_Switch.kicad_sch, Avionics_Internal_I2C.kicad_sch, Avionics_Real_Time_Clock.kicad_sch, Avionics_Watchdog_Timer.kicad_sch]
2024-03-16 The BOM has been BOMmed
    All components have been given an MPN
    [3V3_eFuse.kicad_sch, Avionics_Board.kicad_sch, Avionics_GPIO_Buffers.kicad_sch, Avionics_I2C_Switch.kicad_sch, Avionics_Internal_I2C.kicad_sch, Avionics_Real_Time_Clock.kicad_sch, Avionics_Watchdog_Timer.kicad_sch, Microcontroller.kicad_sch]
2024-03-21 Avionics Board V1.4 Released!
    Dropping the BOM.
    Us here at SilverSat are prepping to get our flight boards made(yay!) and so consolidating and fixing any BOM errors need to be done... so thats whats been done.
    1. Missing MPNs for the FRAM and the IMU have been added
    2. 10k part MPN now actually a 10k(whoops)
    3. R19 MPN changed to diff series, same value component
    4. Mounting Holes, Test Points, and Solder Jumpers now removed from BOM(good riddance)
    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
    [3V3_eFuse.kicad_sch, Avionics_Board.kicad_pcb, Avionics_Board.kicad_sch, Avionics_GPIO_Buffers.kicad_sch, Avionics_I2C_Switch.kicad_sch, Avionics_Internal_I2C.kicad_sch, Avionics_Real_Time_Clock.kicad_sch, Microcontroller.kicad_sch]
2024-04-06 Avionics Board V1.4 Rev. B Released!
    Checkin some changes in.
    1. Added fiducials for Contract Manufacturer
    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
    [Avionics_Board.kicad_pcb, Avionics_Board.kicad_sch]
2024-04-06 Avionics Board 2.0 Released
    Flight Time.
    1. Added Edge Rails for board assembly
    If there are no emergency changes to make, this is the design going to space!
    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
    [Avionics_Board.kicad_pcb]
2024-04-20 Avionics Board 2.0 Rev. B Released
    Whoops, anticipated no more changes needed, was wrong.
    1. Edge Rails ever so slightly modified to add an inside corner arc.
    2. Arcs added to group boxes(yay!)
    3. Regulator and extra bits for raw battery power added.
    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
    [3V3_eFuse.kicad_sch, Avionics_Board.kicad_pcb, Avionics_Board.kicad_sch, Microcontroller.kicad_sch]
2024-04-20 Avionics Board 2.0 Rev. C
    S'more changes
    1. DRC was checked. yay
    2. Silkscreen over pads was fixed
    3. Malformed Courtyard set to warning
    [Avionics_Board.kicad_pcb]
2024-04-20 Avionics Board V2.0 Rev. D
    Even More Changes!
    1. More fixes
    2. Ground Clips
    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
    [3V3_eFuse.kicad_sch, Avionics_Board.kicad_pcb, Avionics_Board.kicad_sch, Avionics_Board.step, Microcontroller.kicad_sch]
2024-05-04 Even more changes...
    More changes to prepare the Avionics Board for manufacture.
    1. Silk Min Thickness changed to 5.9 mils(0.15 mm) and associated Silk text changed
    2. DRC Rules changed slightly
    [Avionics_Board.kicad_pcb, Avionics_Board.kicad_sch]
2024-05-29 production gerbers
    These are the gerber files sent out to Oshpark for the flight boards
    [Avionics_Board-B_Cu.gbl, Avionics_Board-B_Mask.gbs, Avionics_Board-B_Paste.gbp, Avionics_Board-B_Silkscreen.gbo, Avionics_Board-Edge_Cuts.gm1, Avionics_Board-F_Cu.gtl, Avionics_Board-F_Mask.gts, Avionics_Board-F_Paste.gtp]
2024-06-05 BOM Stuff
    Modified DNP and NoBom status on some items.
    Added CSV formatted BOM file (Avionics_Production_BOM.csv)
    This schematic still needs to be updated to match master BOM.
    [3V3_eFuse.kicad_sch, Avionics_Board.kicad_pcb, Avionics_Board.kicad_sch, Avionics_GPIO_Buffers.kicad_sch, Avionics_I2C_Switch.kicad_sch, Avionics_Internal_I2C.kicad_sch, Avionics_Real_Time_Clock.kicad_sch, Avionics_Watchdog_Timer.kicad_sch]
